zinka/IceCore-KiCAD/README.md

# IceCore-KiCAD
A KiCAD version of IceCore (https://github.com/folknology/IceCore) Lattice FPGA board

**Top View**
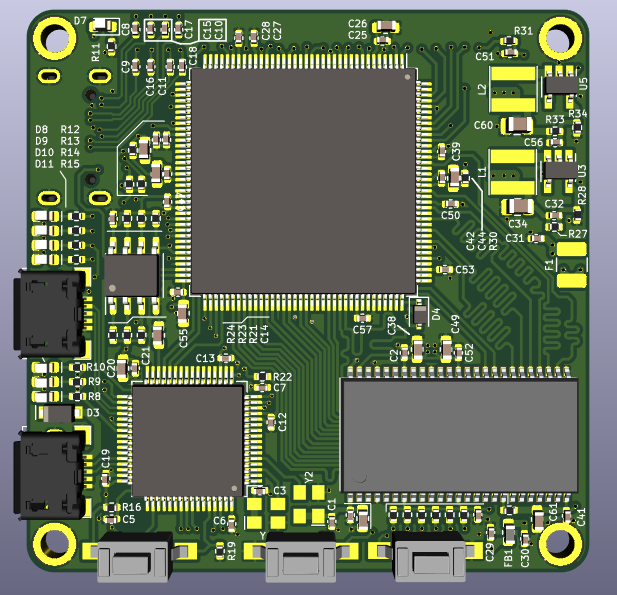
[picture p1: Top.png]


**Bottom View**
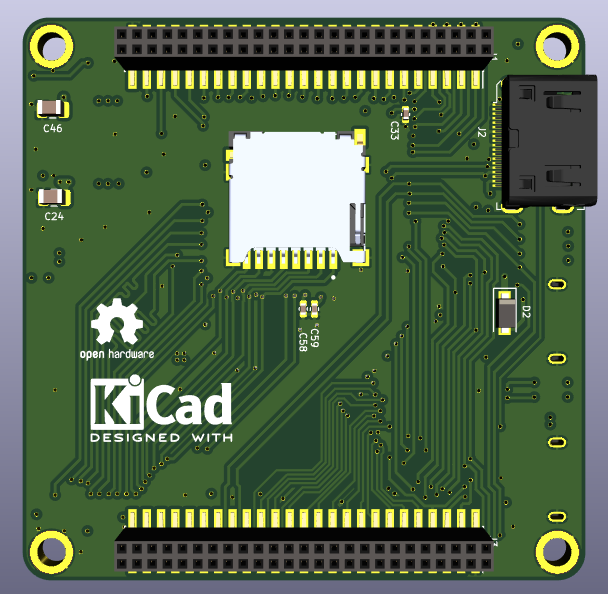
[picture p2: Bot.png]
