zinka/IceCore-KiCAD/IceCore.pdf

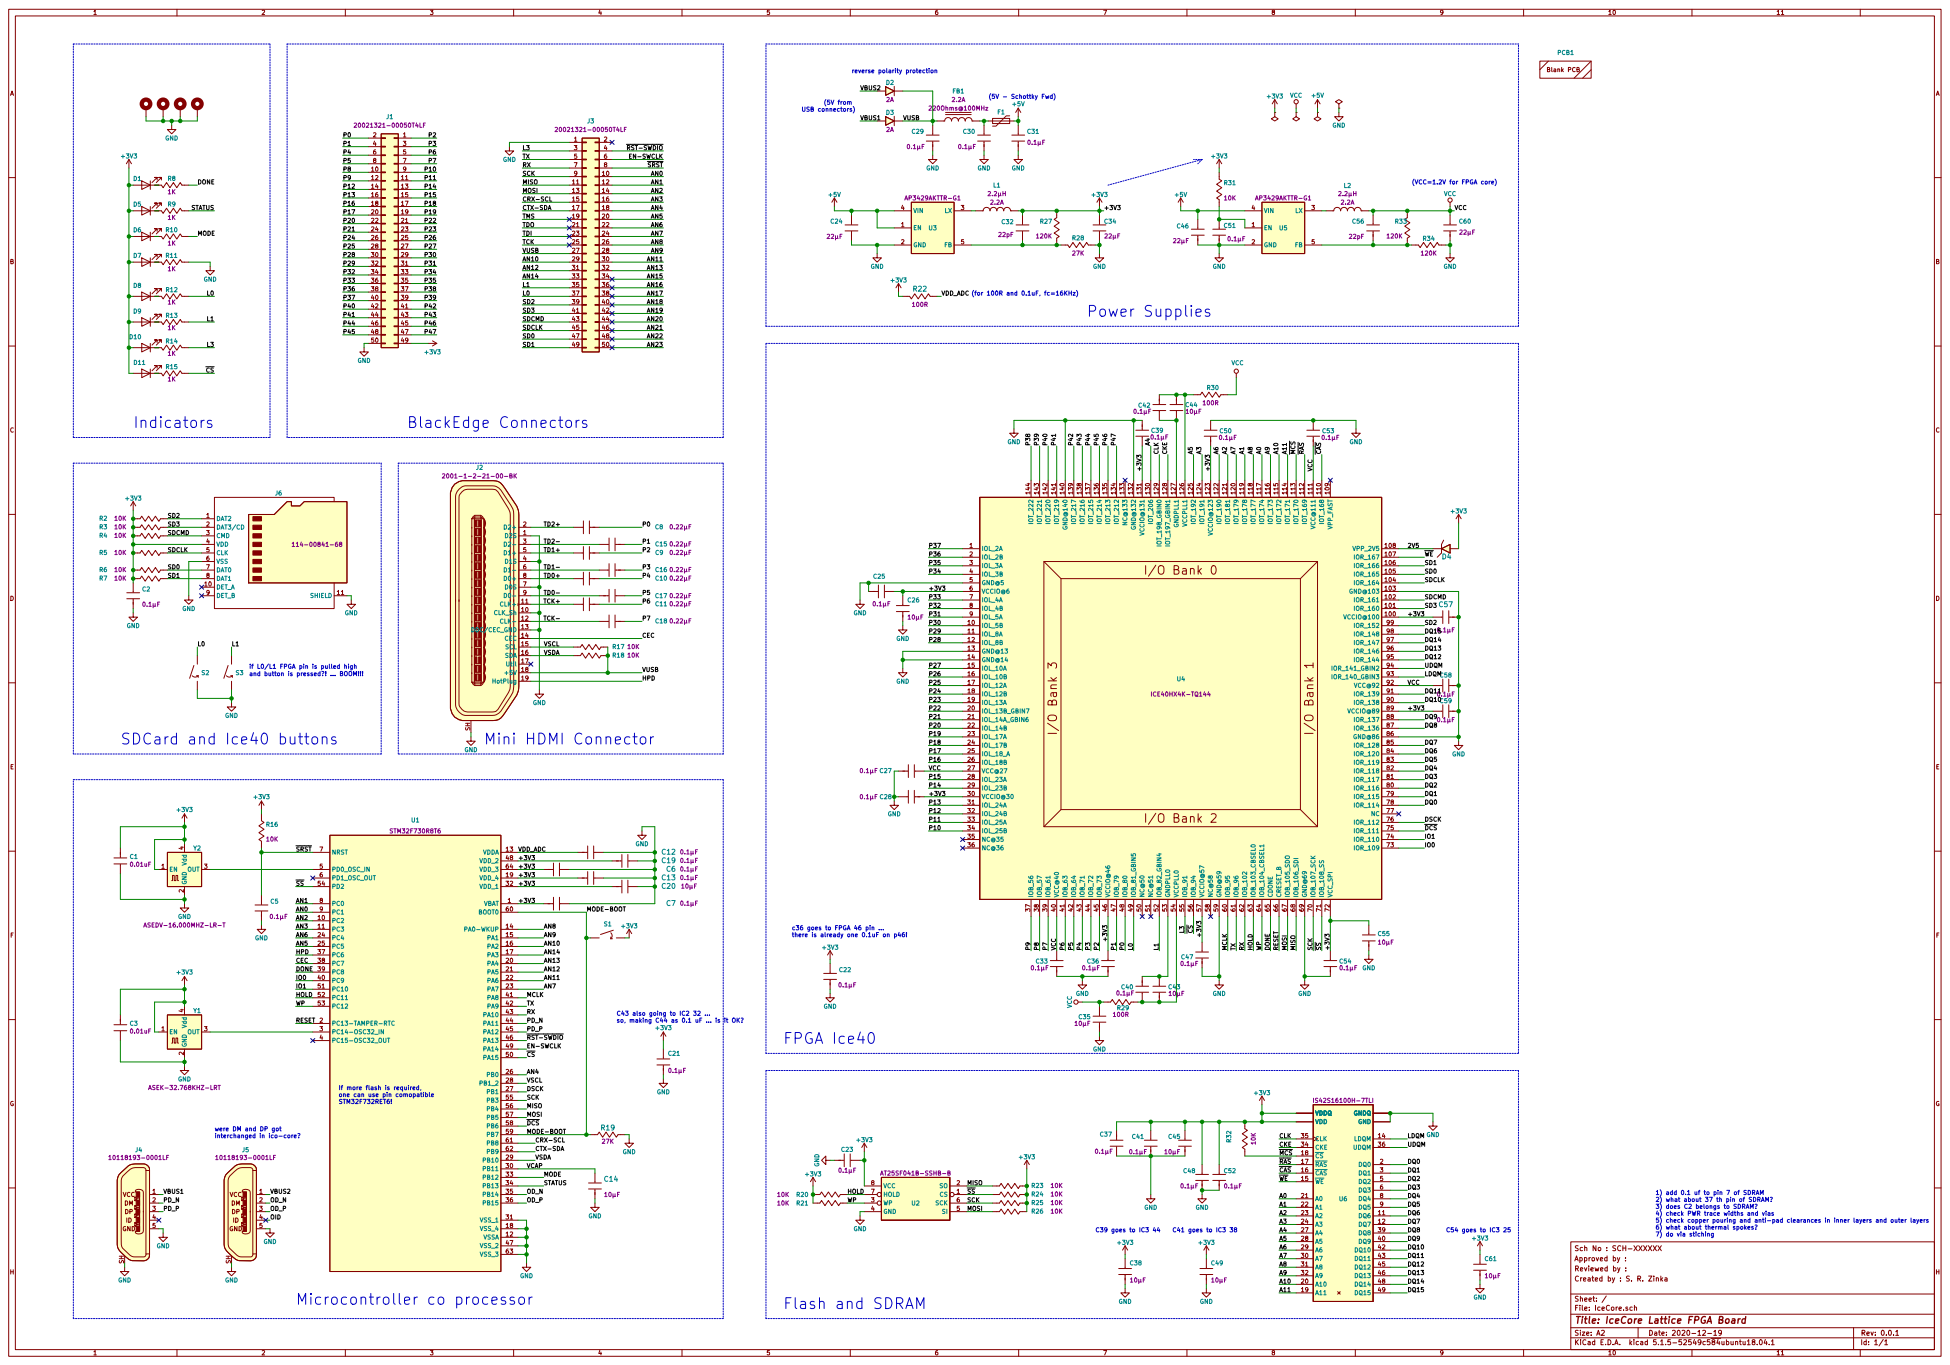
[picture p3: page 1]

(VCC=1.2V for FPGA core)

22µF D2S 1 CLK_Sh 10 CLK+ 11 CLK- 12 DDC/CEC_GND 13 CEC 14 SCL 15 SDA 16 Util 17 +5V 18 HotPlug 19 D2+ 2 D2- 3 D1S 4 D1+ 5 D1- 6 D0S 7 D0+ 8 D0- 9 SH

4Y2 ASEDV-16.000MHZ-LR-T GND GND GND GND GND GND GND GND

if L0/L1 FPGA pin is pulled high
and button is pressed?! ... BOOM!!!

c36 goes to FPGA 46 pin ...
there is already one 0.1uF on p46!

C43 also going to IC2 32 ...
so, making C44 as 0.1 uF ... is it OK?

If more flash is required,

were DM and DP got
interchanged in ico-core?

1) add 0.1 uf to pin 7 of SDRAM
2) what about 37 th pin of SDRAM?
3) does C2 belongs to SDRAM?
4) check PWR trace widths and vias
5) check copper pouring and anti-pad clearances in inner layers and outer layers
6) what about thermal spokes?
7) do via stiching

Approved by : Sch No : SCH-XXXXXX

Reviewed by :
File: IceCore.sch Sheet: / Created by : S. R. Zinka

Id: 1/1 Title: IceCore Lattice FPGA Board
