zinka/IceCore-KiCAD/IceCore.kicad_pcb

## KiCad design IceCore.kicad_pcb (2020-12-19)

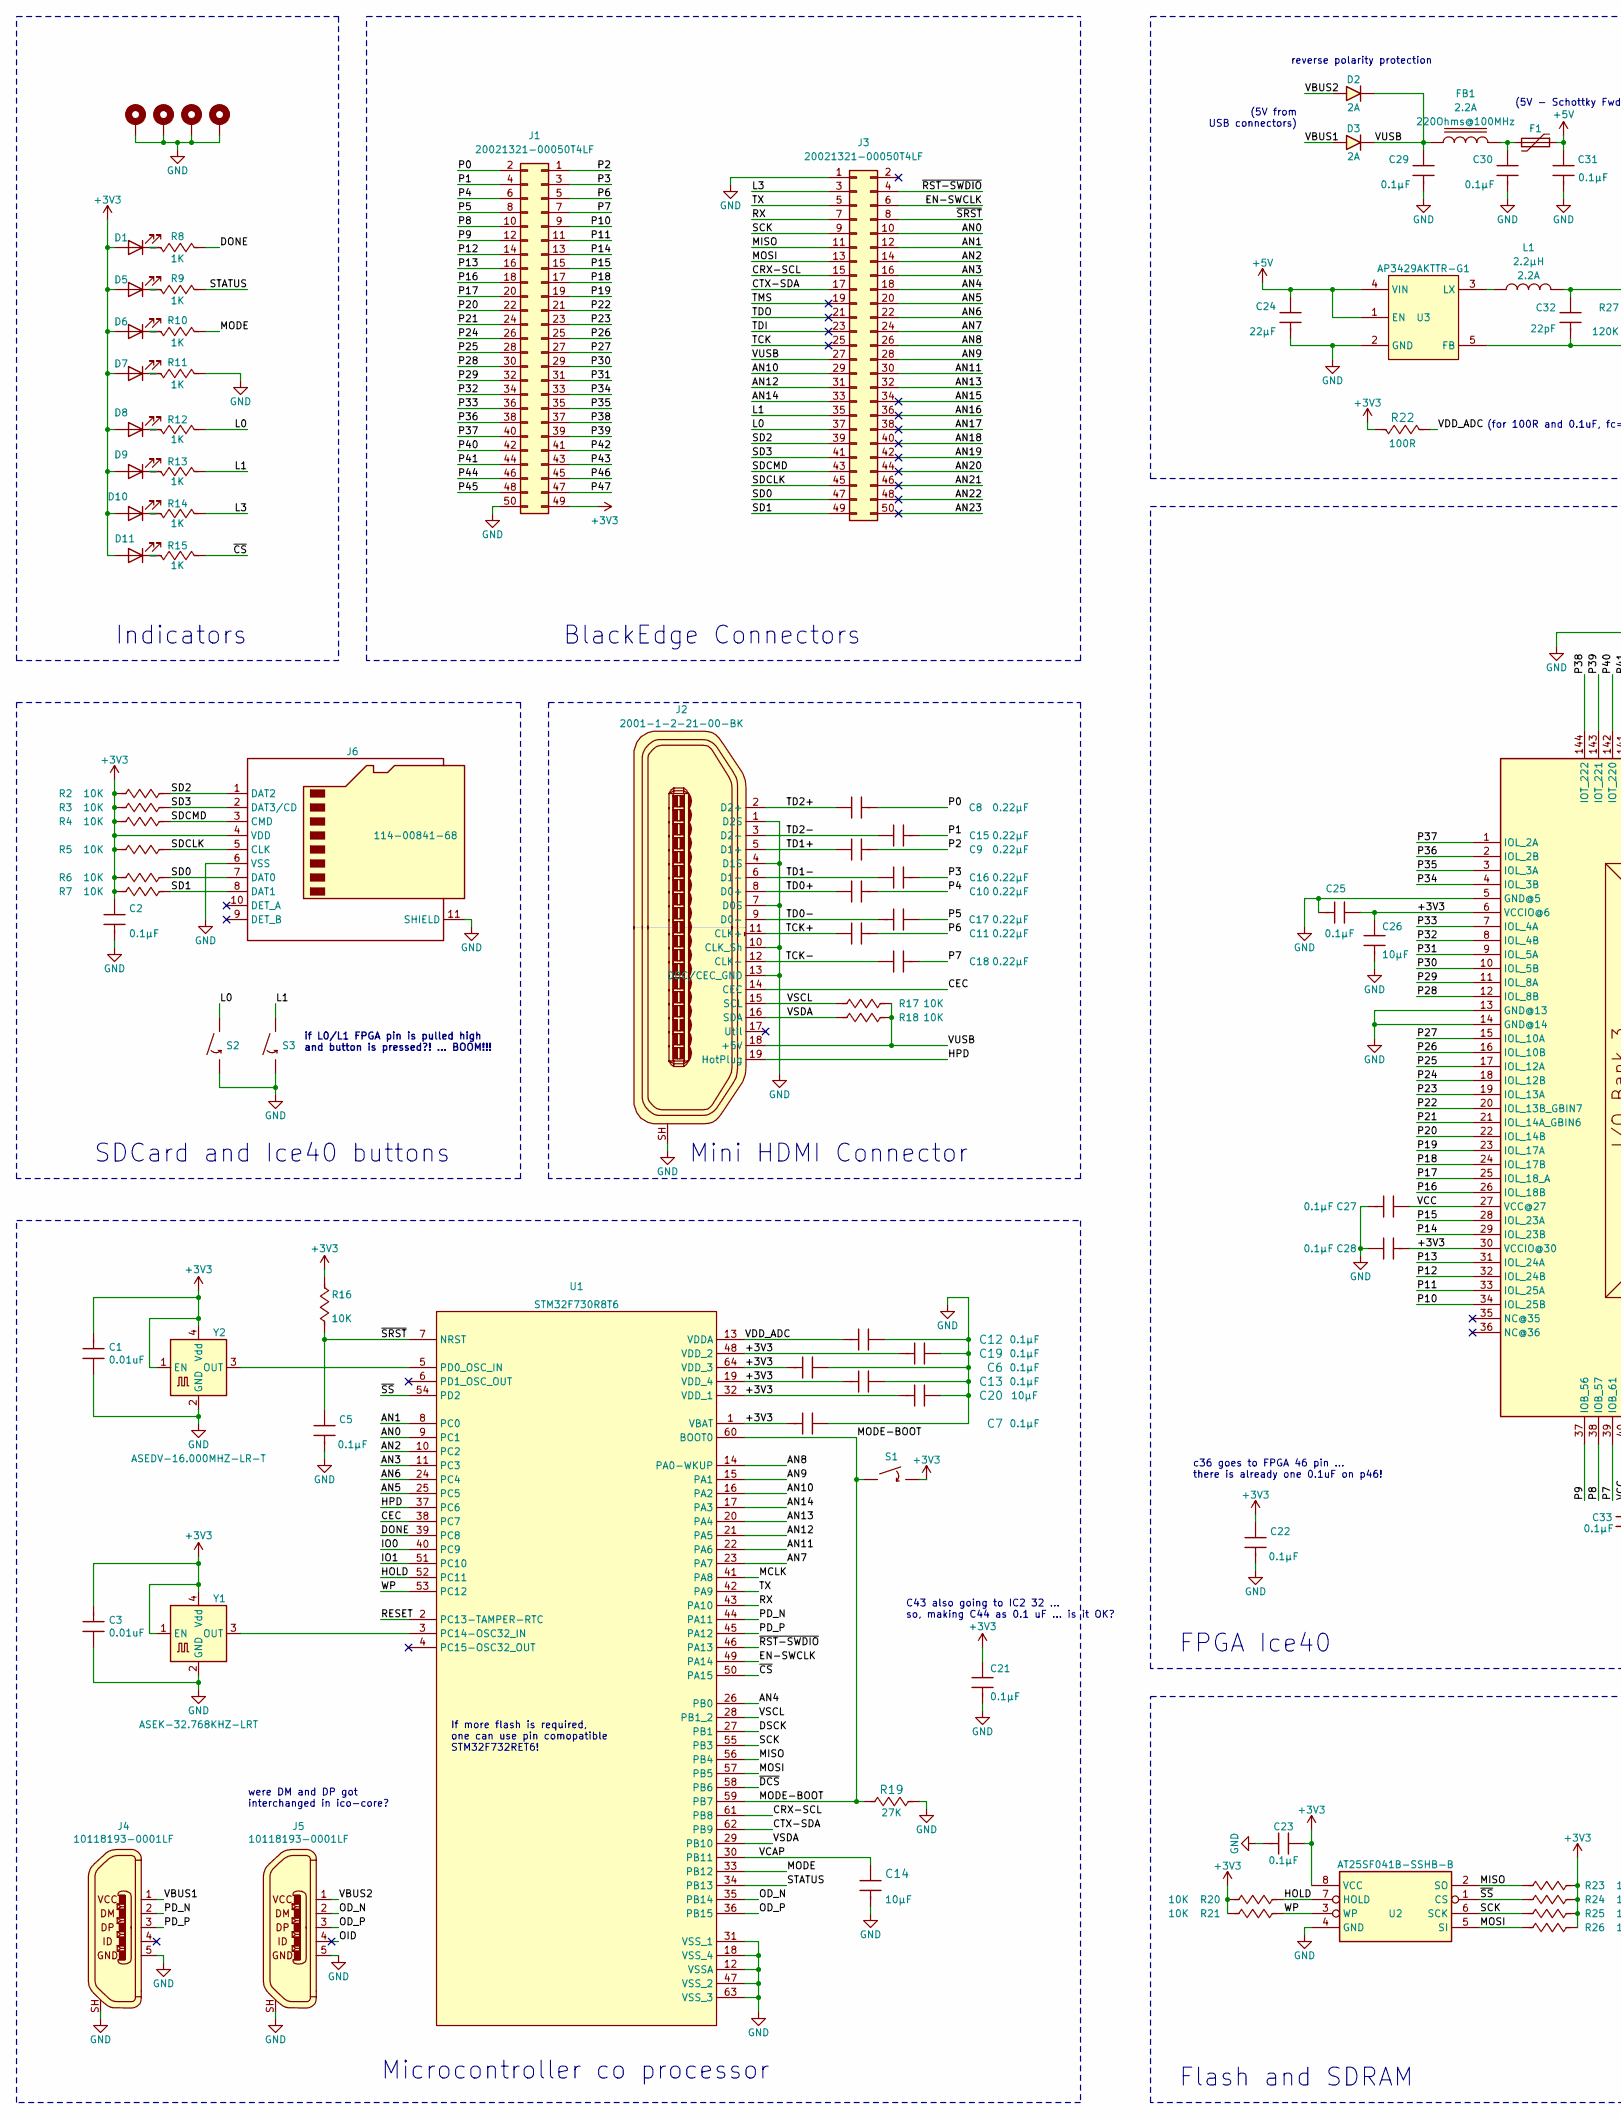
[picture p4: schematic IceCore.sch, IceCore Lattice FPGA Board, part in row 1, column 1]

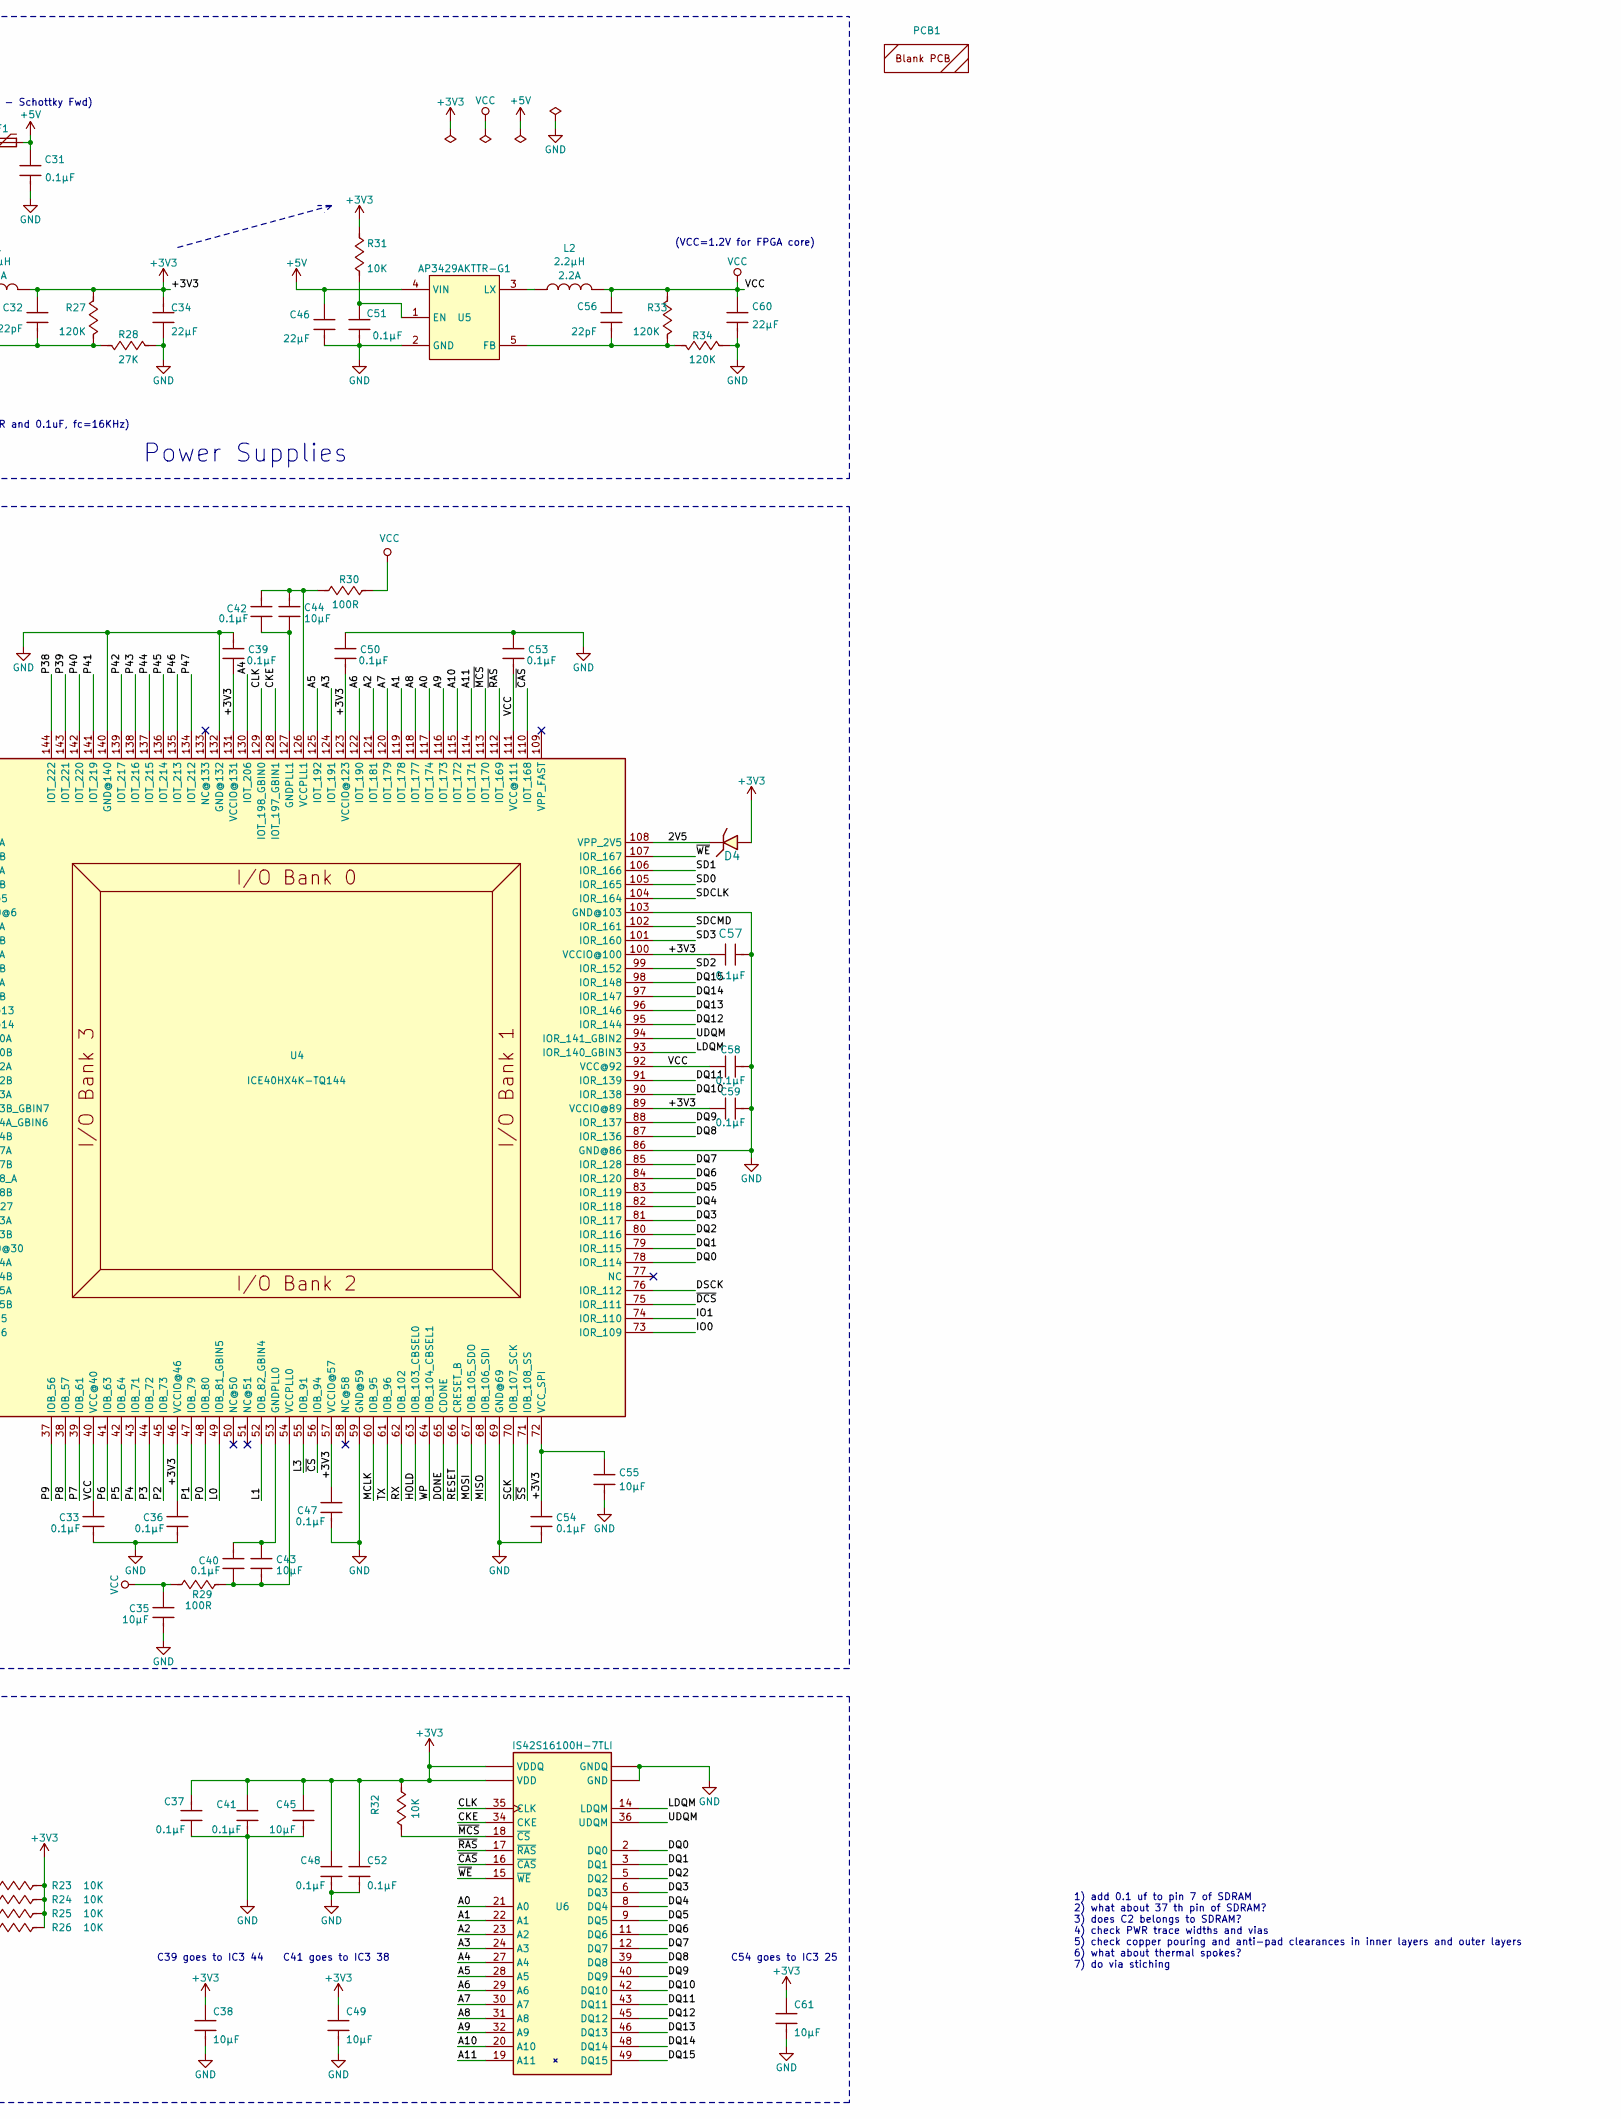
[picture p5: schematic IceCore.sch, IceCore Lattice FPGA Board, part in row 1, column 2]

Parts:
C1, C3: CAP-000017-00; C_0402_1005Metric; Tolerance (%) ±10%; Rated Voltage (Volt) 50V; Manufacturer Part Number GCM155R71H103KA55D
C2, C5, C6, C7, C12, C13, C19, C21, C22, C23, C25, C27, C28, C29, C30, C31, C33, C36, C37, C39, C40, C41, C42, C47, C48, C50, C51, C52, C53, C54, C57, C58, C59: CAP-000004-00; C_0402_1005Metric; Tolerance (%) ±10%; Voltage Rated (Volt) 16V; Manufacturer Part Number GRM155R71C104KA88D
C8, C9, C10, C11, C15, C16, C17, C18: CAP-000182-00; C_0402_1005Metric; Rated Voltage (Volt) 16V; Tolerance (%) ±10%; Manufacturer Part Number GRM155R71C224KA12D
C14, C20, C35, C43, C44, C45: CAP-000178-00; C_0603_1608Metric; Rated Voltage (Volt) 16V; Tolerance (%) ±20%; Manufacturer Part Number CL10X106MO8NRNC
C24, C34, C46, C60: CAP-000164-00; C_0805_2012Metric; Rated Voltage (Volt) 10V; Tolerance (%) ±20%; Manufacturer Part Number GRM21BC81A226ME44L
C26, C38, C49, C55, C61: CAP-000178-00; C_0603_1608Metric; Tolerance (%) ±20%; Rated Voltage (Volt) 16V; Manufacturer Part Number CL10X106MO8NRNC
C32, C56: CAP-000168-00; C_0402_1005Metric; Rated Voltage (Volt) 50V; Tolerance (%) ±5%; Manufacturer Part Number GCM1555C1H220JA16D
D1, D5, D6, D7, D8, D9, D10, D11: DIO-000055-00; LED_0603_1608Metric; Forward Voltage (Volt) 2V; Manufacturer Part Number APT1608EC
D2, D3: DIO-000179-00; D_SOD-123F; Forward Voltage (Volt) 550mV@2A; Rated Voltage (Volt) 40V; Manufacturer Part Number SS24FL
D4: DIO-000186-00; D_SOD-323; Forward Voltage (Volt) 1V@15mA; Rated Voltage (Volt) 70V; Manufacturer Part Number BAS70JFILM
F1: PRO-000190-00; Fuse_1210_3225Metric; Manufacturer Part Number 0ZCH0075AF2E
FB1: IND-000180-00; L_0603_1608Metric; Current Rating (Ampere) 2.2A; Manufacturer Part Number BLM18KG221SN1D
H1, H2, H3, H4: MountingHole_Pad; 2.5MM-HOLE
J1, J3: CON-000177-00; PinSocket_2x25_P1.27mm_Vertical_SMD; Manufacturer Part Number 20021321-00050T4LF
J2: CON-000176-00; HDMI_Mini_Female_2001-1-2-21-00-BK; Manufacturer Part Number 2001-1-2-21-00-BK
J4, J5: CON-000183-00; USB_Micro_B_Female_10118193-0001LF; Manufacturer Part Number 10118193-0001LF
J6: CON-000174-00; AMPHENOL_1140084168; Manufacturer Part Number 114-00841-68
L1, L2: IND-000181-00; L_Taiyo-Yuden_NR-40xx; Current Rating (Ampere) 2.2A; Manufacturer Part Number NRS4018T2R2MDGJ
PCB1: BlankPCB
R2, R3, R4, R5, R6, R7, R16, R17, R18, R20, R21, R23, R24, R25, R26, R31, R32: RES-000076-00; R_0402_1005Metric; Tolerance (%) ±1%; Manufacturer Part Number RC0402FR-1310KL
R8, R9, R10, R11, R12, R13, R14, R15: RES-000092-00; R_0402_1005Metric; Tolerance (%) ±1%; Manufacturer Part Number RC0402FR-071KL
R19, R28: RES-000167-00; R_0402_1005Metric; Tolerance (%) ±1%; Manufacturer Part Number RC0402FR-0727KL
R22, R29, R30: RES-000074-00; R_0402_1005Metric; Tolerance (%) ±1%; Manufacturer Part Number RC0402FR-07100RL
R27, R33, R34: RES-000166-00; R_0402_1005Metric; Tolerance (%) ±1%; Manufacturer Part Number RC0402FR-07120KL
S1, S2, S3: MEC-000189-00; PTS636SL43SMTRLFS; Manufacturer Part Number PTS636 SL43 SMTR LFS
U1: ICS-000169-00; LQFP-64_10x10mm_P0.5mm; Manufacturer Part Number STM32F730R8T6
U2: ICS-000173-00; SOIC-8_3.9x4.9mm_P1.27mm; Manufacturer Part Number AT25SF041B-SSHB-B
U3, U5: PWR-000165-00; TSOT-23-5; Manufacturer Part Number AP3429AKTTR-G1
U4: ICS-000170-00; TQFP-144_20x20mm_P0.5mm; Manufacturer Part Number ICE40HX4K-TQ144
U6: ICS-000172-00; TSOP-2-50; Manufacturer Part Number IS42S16100H-7TLI
Y1: CLK-000184-00; Oscillator_SMD_Abracon_ASE-4Pin_3.2x2.5mm; Manufacturer Part Number ASEK-32.768KHZ-LRT
Y2: CLK-000185-00; Oscillator_SMD_Abracon_ASE-4Pin_3.2x2.5mm; Manufacturer Part Number ASEDV-16.000MHZ-LR-T

Connections:
+3V3: C1.2, C2.1, C3.2, C6.2, C7.2, C13.2, C19.2, C20.2, C21.1, C22.1, C23.1, C25.1, C26.1, C28.2, C32.1, C34.2, C36.1, C37.2, C38.1, C39.1, C41.1, C45.1, C47.1, C48.1, C49.1, C50.2, C52.1, C54.1, C55.1, C57.1, C59.1, C61.1, D1.2 (A), D4.2 (Anode), D5.2 (A), D6.2 (A), D7.2 (A), D8.2 (A), D9.2 (A), D10.2 (A), D11.2 (A), J1.49, J6.4 (VDD), L1.2, R2.2, R3.2, R4.2, R5.2, R6.2, R7.2, R16.2, R20.1, R21.1, R22.1, R23.1, R24.1, R25.1, R26.1, R27.2, R31.1, R32.2, S1.2, U1.1 (VBAT), U1.19 (VDD_4), U1.32 (VDD_1), U1.48 (VDD_2), U1.64 (VDD_3), U2.8 (VCC), U4.6 (VCCIO@6), U4.30 (VCCIO@30), U4.46 (VCCIO@46), U4.57 (VCCIO@57), U4.72 (VCC_SPI), U4.89 (VCCIO@89), U4.100 (VCCIO@100), U4.123 (VCCIO@123), U4.131 (VCCIO@131), U6.1 (VDD), U6.7 (VDDQ), U6.13 (VDDQ), U6.25 (VDD), U6.38 (VDDQ), U6.44 (VDDQ), Y1.1 (EN), Y1.4 (Vdd), Y2.1 (EN), Y2.4 (Vdd)
+5V: C24.1, C31.1, C46.1, F1.1, U3.1 (EN), U3.4 (VIN), U5.4 (VIN)
/2V5: D4.1 (Cathode), U4.108 (VPP_2V5)
/A0: U4.117 (IOT_174), U6.21 (A0)
/A1: U4.119 (IOT_178), U6.22 (A1)
/A2: U4.121 (IOT_181), U6.23 (A2)
/A3: U4.124 (IOT_191), U6.24 (A3)
/A4: U4.130 (IOT_206), U6.27 (A4)
/A5: U4.125 (IOT_192), U6.28 (A5)
/A6: U4.122 (IOT_190), U6.29 (A6)
/A7: U4.120 (IOT_179), U6.30 (A7)
/A8: U4.118 (IOT_177), U6.31 (A8)
/A9: U4.116 (IOT_173), U6.32 (A9)
/A10: U4.115 (IOT_172), U6.20 (A10)
/A11: U4.114 (IOT_171), U6.19 (A11)
/AN0: J3.10, U1.9 (PC1)
/AN1: J3.12, U1.8 (PC0)
/AN2: J3.14, U1.10 (PC2)
/AN3: J3.16, U1.11 (PC3)
/AN4: J3.18, U1.26 (PB0)
/AN5: J3.20, U1.25 (PC5)
/AN6: J3.22, U1.24 (PC4)
/AN7: J3.24, U1.23 (PA7)
/AN8: J3.26, U1.14 (PA0-WKUP)
/AN9: J3.28, U1.15 (PA1)
/AN10: J3.29, U1.16 (PA2)
/AN11: J3.30, U1.22 (PA6)
/AN12: J3.31, U1.21 (PA5)
/AN13: J3.32, U1.20 (PA4)
/AN14: J3.33, U1.17 (PA3)
/AN15: J3.34
/AN16: J3.36
/AN17: J3.38
/AN18: J3.40
/AN19: J3.42
/AN20: J3.44
/AN21: J3.46
/AN22: J3.48
/AN23: J3.50
/CEC: J2.14 (CEC), U1.38 (PC7)
/CKE: U4.128 (IOT_197_GBIN1), U6.34 (CKE)
/CLK: U4.129 (IOT_198_GBIN0), U6.35 (CLK)
/CRX-SCL: J3.15, U1.61 (PB8)
/CTX-SDA: J3.17, U1.62 (PB9)
/DONE: R8.1, U1.39 (PC8), U4.65 (CDONE)
/DQ0: U4.78 (IOR_114), U6.2 (DQ0)
/DQ1: U4.79 (IOR_115), U6.3 (DQ1)
/DQ2: U4.80 (IOR_116), U6.5 (DQ2)
/DQ3: U4.81 (IOR_117), U6.6 (DQ3)
/DQ4: U4.82 (IOR_118), U6.8 (DQ4)
/DQ5: U4.83 (IOR_119), U6.9 (DQ5)
/DQ6: U4.84 (IOR_120), U6.11 (DQ6)
/DQ7: U4.85 (IOR_128), U6.12 (DQ7)
/DQ8: U4.87 (IOR_136), U6.39 (DQ8)
/DQ9: U4.88 (IOR_137), U6.40 (DQ9)
/DQ10: U4.90 (IOR_138), U6.42 (DQ10)
/DQ11: U4.91 (IOR_139), U6.43 (DQ11)
/DQ12: U4.95 (IOR_144), U6.45 (DQ12)
/DQ13: U4.96 (IOR_146), U6.46 (DQ13)
/DQ14: U4.97 (IOR_147), U6.48 (DQ14)
/DQ15: U4.98 (IOR_148), U6.49 (DQ15)
/DSCK: U1.27 (PB1), U4.76 (IOR_112)
/EN-SWCLK: J3.6, U1.49 (PA14)
/HOLD: R20.2, U1.52 (PC11), U2.7 (HOLD), U4.63 (IOB_103_CBSEL0)
/HPD: J2.19 (HotPlug), U1.37 (PC6)
/IO0: U1.40 (PC9), U4.73 (IOR_109)
/IO1: U1.51 (PC10), U4.74 (IOR_110)
/L0: J3.37, R12.2, S2.1, U4.49 (IOB_81_GBIN5)
/L1: J3.35, R13.2, S3.1, U4.52 (IOB_82_GBIN4)
/L3: J3.3, R14.2, U4.55 (IOB_91)
/LDQM: U4.93 (IOR_140_GBIN3), U6.14 (LDQM)
/MCLK: U1.41 (PA8), U4.60 (IOB_95)
/MISO: J3.11, R23.2, U1.56 (PB4), U2.2 (SO), U4.68 (IOB_106_SDI)
/MODE: R10.1, U1.33 (PB12)
/MODE-BOOT: R19.1, S1.1, U1.59 (PB7), U1.60 (BOOT0)
/MOSI: J3.13, R26.2, U1.57 (PB5), U2.5 (SI), U4.67 (IOB_105_SDO)
/OD_N: J5.2, U1.35 (PB14)
/OD_P: J5.3, U1.36 (PB15)
/OID: J5.4
/P0: C8.2, J1.2, U4.48 (IOB_80)
/P1: C15.2, J1.4, U4.47 (IOB_79)
/P2: C9.2, J1.1, U4.45 (IOB_73)
/P3: C16.2, J1.3, U4.44 (IOB_72)
/P4: C10.2, J1.6, U4.43 (IOB_71)
/P5: C17.1, J1.8, U4.42 (IOB_64)
/P6: C11.2, J1.5, U4.41 (IOB_63)
/P7: C18.2, J1.7, U4.39 (IOB_61)
/P8: J1.10, U4.38 (IOB_57)
/P9: J1.12, U4.37 (IOB_56)
/P10: J1.9, U4.34 (IOL_25B)
/P11: J1.11, U4.33 (IOL_25A)
/P12: J1.14, U4.32 (IOL_24B)
/P13: J1.16, U4.31 (IOL_24A)
/P14: J1.13, U4.29 (IOL_23B)
/P15: J1.15, U4.28 (IOL_23A)
/P16: J1.18, U4.26 (IOL_18B)
/P17: J1.20, U4.25 (IOL_18_A)
/P18: J1.17, U4.24 (IOL_17B)
/P19: J1.19, U4.23 (IOL_17A)
/P20: J1.22, U4.22 (IOL_14B)
/P21: J1.24, U4.21 (IOL_14A_GBIN6)
/P22: J1.21, U4.20 (IOL_13B_GBIN7)
/P23: J1.23, U4.19 (IOL_13A)
/P24: J1.26, U4.18 (IOL_12B)
/P25: J1.28, U4.17 (IOL_12A)
/P26: J1.25, U4.16 (IOL_10B)
/P27: J1.27, U4.15 (IOL_10A)
/P28: J1.30, U4.12 (IOL_8B)
/P29: J1.32, U4.11 (IOL_8A)
/P30: J1.29, U4.10 (IOL_5B)
/P31: J1.31, U4.9 (IOL_5A)
/P32: J1.34, U4.8 (IOL_4B)
/P33: J1.36, U4.7 (IOL_4A)
/P34: J1.33, U4.4 (IOL_3B)
/P35: J1.35, U4.3 (IOL_3A)
/P36: J1.38, U4.2 (IOL_2B)
/P37: J1.40, U4.1 (IOL_2A)
/P38: J1.37, U4.144 (IOT_222)
/P39: J1.39, U4.143 (IOT_221)
/P40: J1.42, U4.142 (IOT_220)
/P41: J1.44, U4.141 (IOT_219)
/P42: J1.41, U4.139 (IOT_217)
/P43: J1.43, U4.138 (IOT_216)
/P44: J1.46, U4.137 (IOT_215)
/P45: J1.48, U4.136 (IOT_214)
/P46: J1.45, U4.135 (IOT_213)
/P47: J1.47, U4.134 (IOT_212)
/PD_N: J4.2, U1.44 (PA11)
/PD_P: J4.3, U1.45 (PA12)
/RESET: U1.2 (PC13-TAMPER-RTC), U4.66 (CRESET_B)
/RX: J3.7, U1.43 (PA10), U4.62 (IOB_102)
/SCK: J3.9, R25.2, U1.55 (PB3), U2.6 (SCK), U4.70 (IOB_107_SCK)
/SD0: J3.47, J6.7 (DAT0), R6.1, U4.105 (IOR_165)
/SD1: J3.49, J6.8 (DAT1), R7.1, U4.106 (IOR_166)
/SD2: J3.39, J6.1 (DAT2), R2.1, U4.99 (IOR_152)
/SD3: J3.41, J6.2 (DAT3/CD), R3.1, U4.101 (IOR_160)
/SDCLK: J3.45, J6.5 (CLK), R5.1, U4.104 (IOR_164)
/SDCMD: J3.43, J6.3 (CMD), R4.1, U4.102 (IOR_161)
/STATUS: R9.1, U1.34 (PB13)
/TCK: J3.25
/TCK+: C11.1, J2.11 (CLK+)
/TCK-: C18.1, J2.12 (CLK-)
/TD0+: C10.1, J2.8 (D0+)
/TD0-: C17.2, J2.9 (D0-)
/TD1+: C9.1, J2.5 (D1+)
/TD1-: C16.1, J2.6 (D1-)
/TD2+: C8.1, J2.2 (D2+)
/TD2-: C15.1, J2.3 (D2-)
/TDI: J3.23
/TDO: J3.21
/TMS: J3.19
/TX: J3.5, U1.42 (PA9), U4.61 (IOB_96)
/UDQM: U4.94 (IOR_141_GBIN2), U6.36 (UDQM)
/VBUS1: D3.2 (Anode), J4.1
/VBUS2: D2.2 (Anode), J5.1
/VCAP: C14.1, U1.30 (PB11)
/VDD_ADC: C12.2, R22.2, U1.13 (VDDA)
/VSCL: J2.15 (SCL), R17.2, U1.28 (PB1_2)
/VSDA: J2.16 (SDA), R18.2, U1.29 (PB10)
/VUSB: C29.1, D2.1 (Cathode), D3.1 (Cathode), FB1.1, J2.18 (+5V), J3.27, R17.1, R18.1
/WP: R21.2, U1.53 (PC12), U2.3 (WP), U4.64 (IOB_104_CBSEL1)
/~CAS: U4.110 (IOT_168), U6.16 (~CAS)
/~CS: R15.2, U1.50 (PA15), U4.56 (IOB_94)
/~DCS: U1.58 (PB6), U4.75 (IOR_111)
/~MCS: R32.1, U4.113 (IOT_170), U6.18 (~CS)
/~RAS: U4.112 (IOT_169), U6.17 (~RAS)
/~RST-SWDIO: J3.4, U1.46 (PA13)
/~SRST: C5.1, J3.8, R16.1, U1.7 (NRST)
/~SS: R24.2, U1.54 (PD2), U2.1 (CS), U4.71 (IOB_108_SS)
/~WE: U4.107 (IOR_167), U6.15 (~WE)
GND: C1.1, C2.2, C3.1, C5.2, C6.1, C7.1, C12.1, C13.1, C14.2, C19.1, C20.1, C21.2, C22.2, C23.2, C24.2, C25.2, C26.2, C27.2, C28.1, C29.2, C30.2, C31.2, C33.2, C34.1, C35.2, C36.2, C37.1, C38.2, C39.2, C41.2, C45.2, C46.2, C47.2, C48.2, C49.2, C50.1, C51.2, C52.2, C53.1, C54.2, C55.2, C57.2, C58.2, C59.2, C60.2, C61.2, H1.1, H2.1, H3.1, H4.1, J1.50, J2.1 (D2S), J2.4 (D1S), J2.7 (D0S), J2.10 (CLK_Sh), J2.13 (DDC/CEC_GND), J2.SH, J3.1, J4.5, J4.SH, J5.5, J5.SH, J6.6 (VSS), J6.11 (SHIELD), R11.1, R19.2, R28.2, R34.2, S2.2, S3.2, U1.12 (VSSA), U1.18 (VSS_4), U1.31 (VSS_1), U1.47 (VSS_2), U1.63 (VSS_3), U2.4 (GND), U3.2 (GND), U4.5 (GND@5), U4.13 (GND@13), U4.14 (GND@14), U4.59 (GND@59), U4.69 (GND@69), U4.86 (GND@86), U4.103 (GND@103), U4.132 (GND@132), U4.140 (GND@140), U5.2 (GND), U6.4 (GNDQ), U6.10 (GNDQ), U6.26 (GND), U6.41 (GNDQ), U6.47 (GNDQ), U6.50 (GND), Y1.2 (GND), Y2.2 (GND)
unnamed: C30.1, F1.2, FB1.2
unnamed: C32.2, R27.1, R28.1, U3.5 (FB)
unnamed: C40.1, C43.2, R29.1, U4.54 (VCCPLL0)
unnamed: C40.2, C43.1, U4.53 (GNDPLL0)
unnamed: C42.1, C44.1, U4.127 (GNDPLL1)
unnamed: C42.2, C44.2, R30.2, U4.126 (VCCPLL1)
unnamed: C51.1, R31.2, U5.1 (EN)
unnamed: C56.2, R33.1, R34.1, U5.5 (FB)
unnamed: D1.1 (K), R8.2
unnamed: D5.1 (K), R9.2
unnamed: D6.1 (K), R10.2
unnamed: D7.1 (K), R11.2
unnamed: D8.1 (K), R12.1
unnamed: D9.1 (K), R13.1
unnamed: D10.1 (K), R14.1
unnamed: D11.1 (K), R15.1
unnamed: L1.1, U3.3 (LX)
unnamed: L2.1, U5.3 (LX)
unnamed: U1.3 (PC14-OSC32_IN), Y1.3 (OUT)
unnamed: U1.5 (PD0_OSC_IN), Y2.3 (OUT)
VCC: C27.1, C33.1, C35.1, C53.2, C56.1, C58.1, C60.1, L2.2, R29.2, R30.1, R33.2, U4.27 (VCC@27), U4.40 (VCC@40), U4.92 (VCC@92), U4.111 (VCC@111)

Notes on the sheet:
BlackEdge Connectors
Mini HDMI Connector
FPGA Ice40
Flash and SDRAM
Microcontroller co processor
SDCard and Ice40 buttons
Indicators
Power Supplies
C39 goes to IC3 44
C43 also going to IC2 32 ... so, making C44 as 0.1 uF ... is it OK?
c36 goes to FPGA 46 pin ... there is already one 0.1uF on p46!
C41 goes to IC3 38
C54 goes to IC3 25
reverse polarity protection
(5V from USB connectors)
(5V - Schottky Fwd)
(VCC=1.2V for FPGA core)
(for 100R and 0.1uF, fc=16KHz)
if L0/L1 FPGA pin is pulled high and button is pressed?! ... BOOM!!!
If more flash is required, one can use pin comopatible STM32F732RET6!
were DM and DP got interchanged in ico-core?
1) add 0.1 uf to pin 7 of SDRAM 2) what about 37 th pin of SDRAM? 3) does C2 belongs to SDRAM? 4) check PWR trace widths and vias 5) check copper pouring and anti-pad clearances in inner layers and outer layers 6) what about thermal spokes? 7) do via stiching

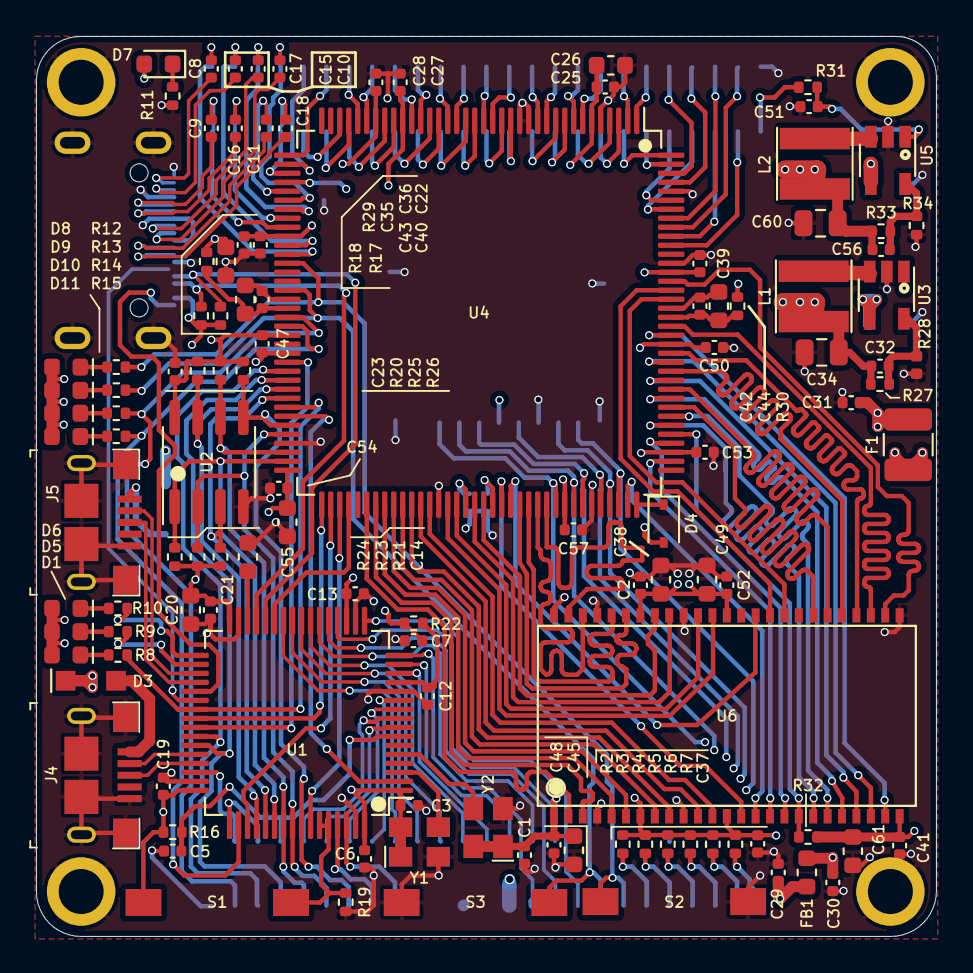
[picture p6: board IceCore.kicad_pcb from above]

Board: 4 copper layers, 50.0 x 50.0 mm, 129 parts (0 on the bottom side), 178 nets.
